ilyakorni/ka-band-patch-array/cad/pcb_driven_patch.step

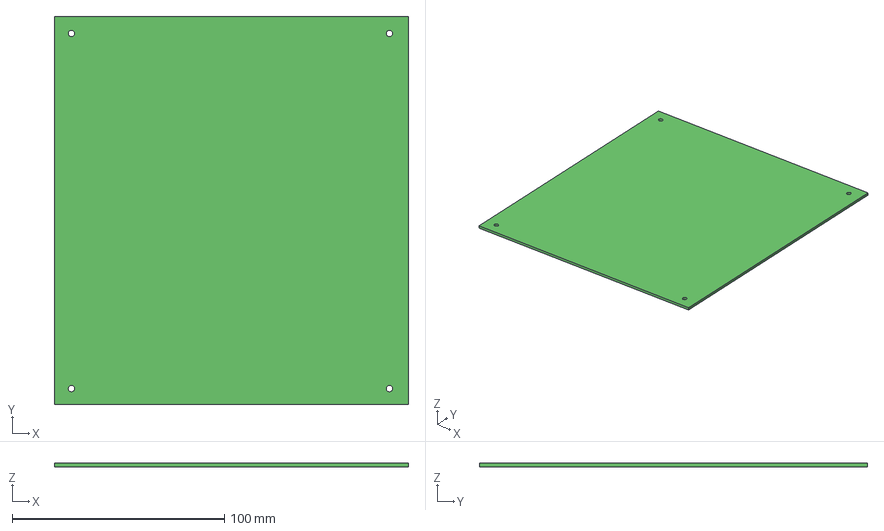
[picture p50: CAD file, 2026-10-11]
cad/pcb_driven_patch.step
167.0 x 183.0 x 1.69 mm
