ilyakorni/ka-band-patch-array/cad/antenna_enclosure_base.step

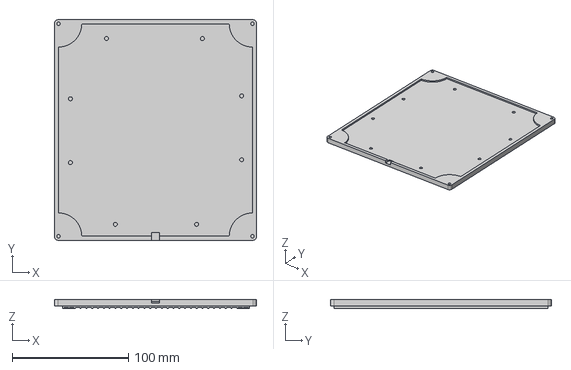
[picture p51: CAD file, 2026-10-11]
cad/antenna_enclosure_base.step
174.0 x 190.0 x 7.70 mm
