ilyakorni/ka-band-patch-array/cad/sma_edgemount_connector.step

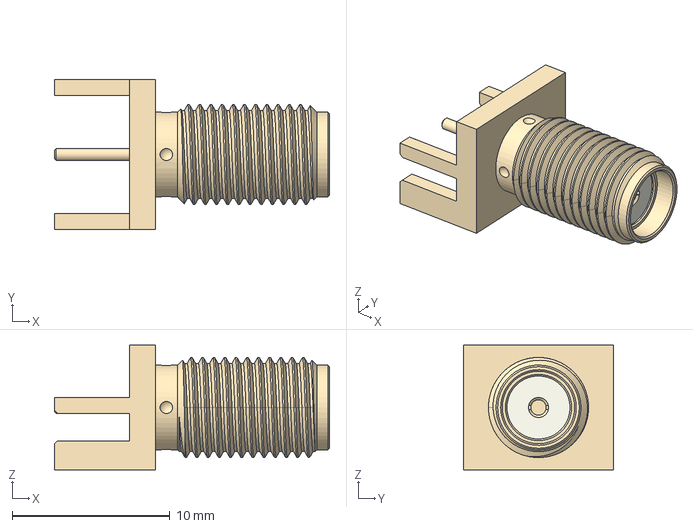
[picture p52: CAD file, 2026-10-11]
cad/sma_edgemount_connector.step
17.5 x 9.52 x 7.92 mm
