ilyakorni/ka-band-patch-array/cad/antenna_enclosure_cover.step

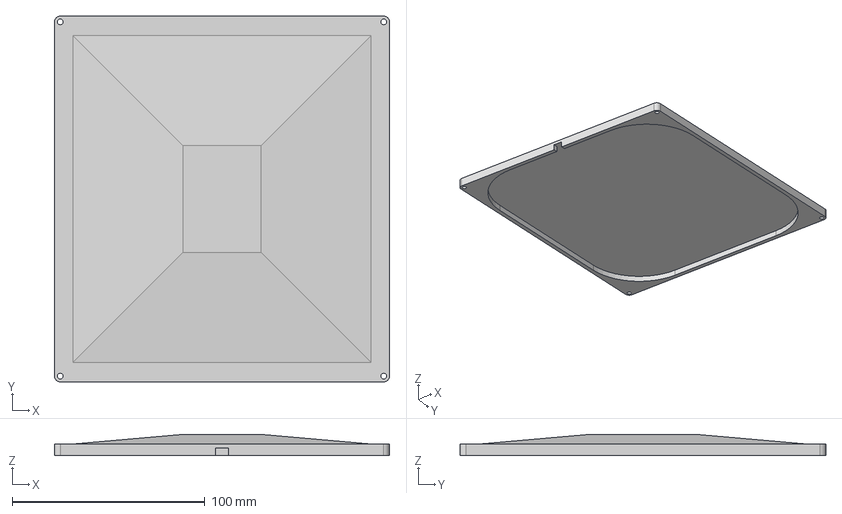
[picture p53: CAD file, 2026-10-11]
cad/antenna_enclosure_cover.step
174.0 x 190.0 x 11.0 mm
