ilyakorni/ka-band-patch-array/cad/pcb_parasitic_patch.step

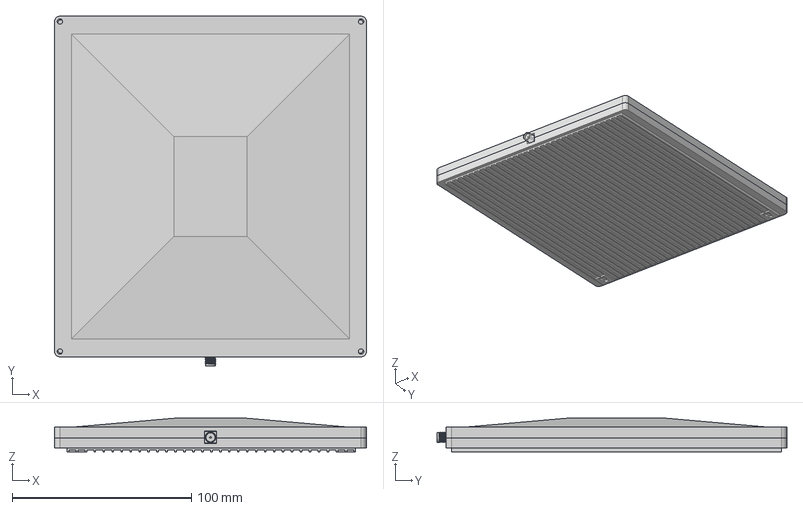
[picture p54: CAD file, 2026-10-11]
cad/pcb_parasitic_patch.step
174.0 x 195.0 x 18.7 mm
