ilyakorni/ka-band-patch-array/(list of files, drawings)

Other design files:
cad/antenna_pcb_layout.pcbdoc
