ilyakorni/ka-band-patch-array/(commit log)

2026-10-11 feat: initialize repository with Ka-band CP stacked patch antenna design
    - Add 3D CAD STEP models, Altium PCB layout, and ODB++ manufacturing archive
    - Add Mathcad analytical calculations for microstrip feed and cross-slot aperture
    - Add full-wave CST Studio Suite numerical electromagnetic simulation project
    - Add macOS, CST Studio Suite, Altium Designer, and Mathcad-tailored .gitignore
    - Include CERN-OHL-P v2 permissive open hardware license
    - Add localized documentation across Russian, English, and German (README.md, README.en.md, README.de.md)
    [antenna_enclosure_base.step, antenna_enclosure_cover.step, antenna_pcb_layout.pcbdoc, pcb_driven_patch.step, pcb_parasitic_patch.step, sma_edgemount_connector.step]
2026-10-11 docs: revise documentation to 28-30 GHz wideband and refine modeling scope
    - Update operating bandwidth specification to broadband 28.0-30.0 GHz
    - Reformat content removing bullet points in favor of clean newline paragraphs
    - Remove LICENSE link from project structure tree
    - Correct 3D modeling section by removing connector and enclosure simulation claims
2026-10-11 feat(docs): add parasitic patch dimensions and -10 dB S11 bandwidth boundaries
    - Add parasitic patch dimensional topology (2.01 mm patch, 0.29 mm corner cuts, 0.203 mm substrate)
    - Add lower and upper -10 dB return loss band edge graphs (27.938 GHz and 29.576 GHz)
    - Update README documentation (RU, EN, DE) with new assets and bandwidth analysis
2026-10-11 feat(docs): document 8x8 array investigation and surface wave coupling effects
    - Add 8x8 planar array 3D directivity (21.63 dBi), E-field, and polar gain (21.3 dBi)
    - Document multi-port VSWR resonance dispersal due to mutual coupling
    - Analyze circular polarization breakdown across 28, 29, and 30 GHz caused by substrate surface waves
    - Update documentation in RU, EN, and DE with clear line breaks and LaTeX formatting
2026-10-11 feat(docs): document ground perforation surface wave suppression and element retuning
2026-10-11 feat(docs): document final optimized 8x8 array integration, stackup, and phased beam steering
2026-10-11 feat(docs): add beam steering axial ratio polar plots demonstrating circular polarization preservation
